FarwayDot/251115_ControlBoard/LIB_CAD/IRM-10 v3.step

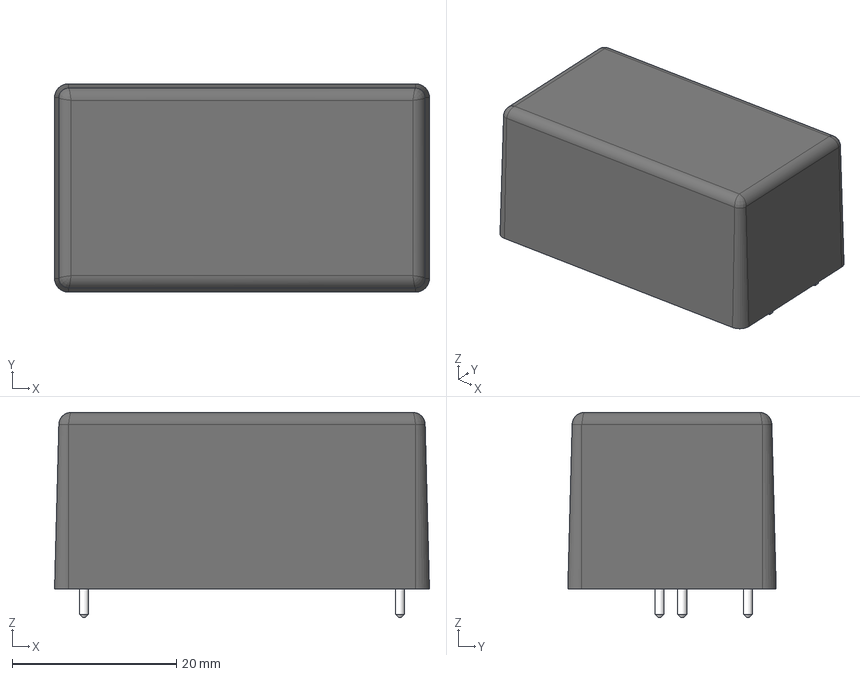
[picture p1: CAD file, 2025-11-26]
LIB_CAD/IRM-10 v3.step
45.7 x 25.4 x 25.0 mm
