FarwayDot/251115_ControlBoard/LIB_CAD/15EDGVC-3.81-06P-14-00AH.STEP

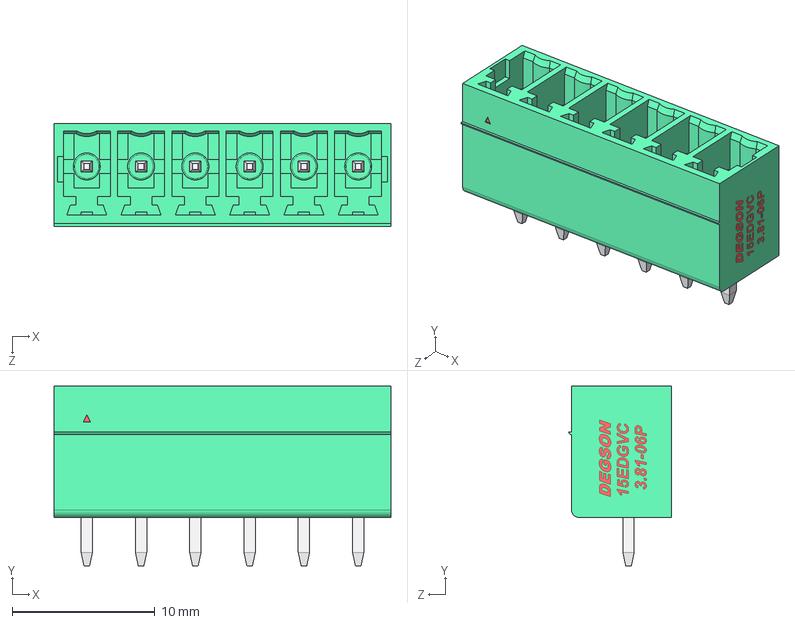
[picture p2: CAD file, 2025-11-24]
LIB_CAD/15EDGVC-3.81-06P-14-00AH.STEP
23.7 x 12.6 x 7.20 mm
