FarwayDot/251115_ControlBoard/LIB_CAD/15EDGK-3.81-06P-14-00AH.STEP

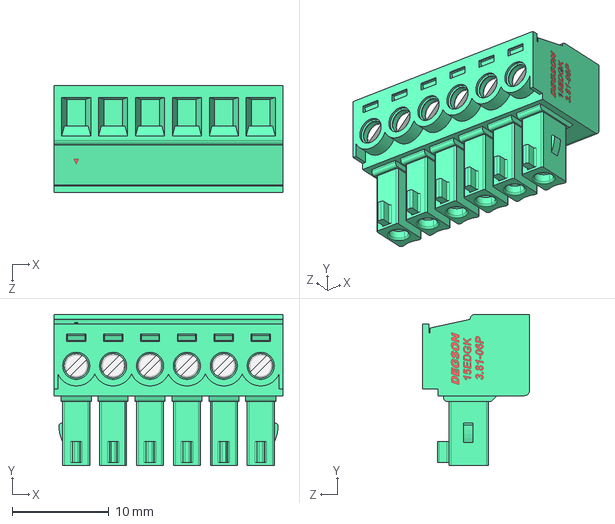
[picture p3: CAD file, 2025-11-24]
LIB_CAD/15EDGK-3.81-06P-14-00AH.STEP
23.7 x 15.6 x 11.1 mm
