FarwayDot/251115_ControlBoard/LIB_CAD/15EDGK-3.81-04P-14-00A&Z(H).stp

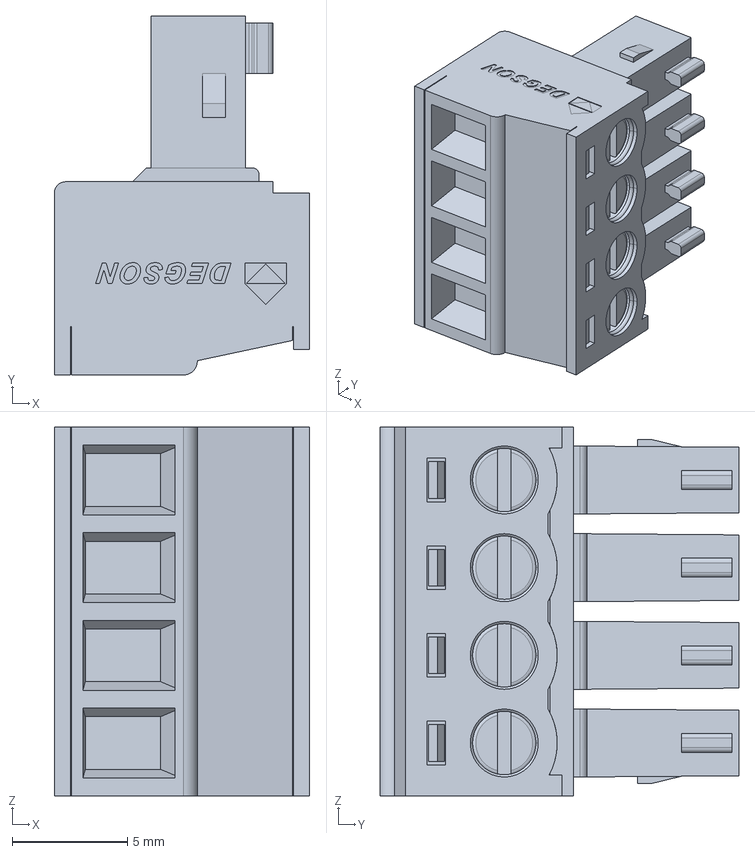
[picture p4: CAD file, 2025-11-21]
LIB_CAD/15EDGK-3.81-04P-14-00A&Z(H).stp
11.1 x 15.6 x 16.0 mm
