FarwayDot/251115_ControlBoard/LIB_CAD/15EDGVC-3.81-04P-14-00A&Z(H).stp

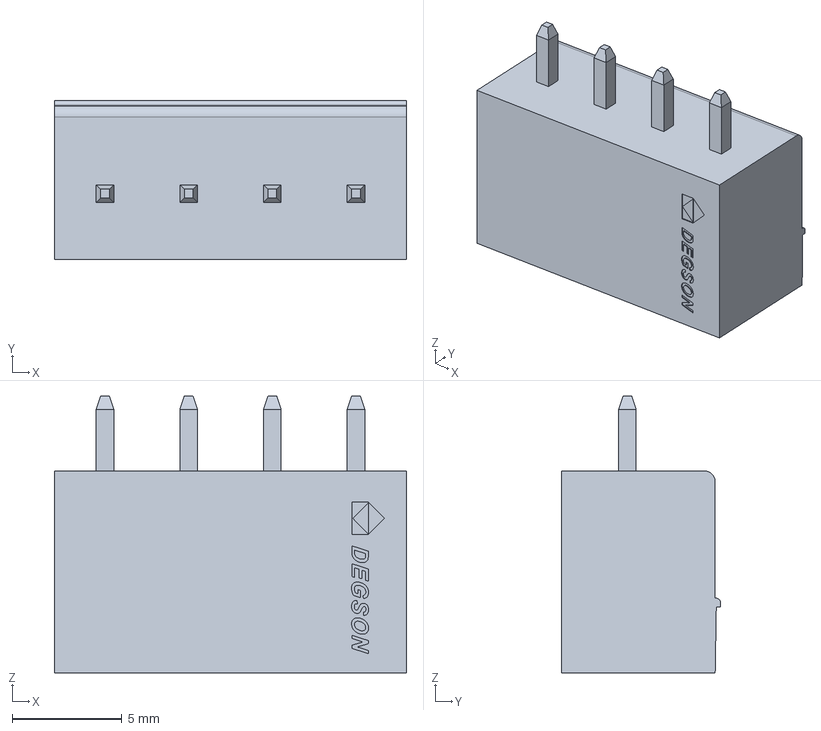
[picture p5: CAD file, 2025-11-21]
LIB_CAD/15EDGVC-3.81-04P-14-00A&Z(H).stp
16.0 x 7.24 x 12.6 mm
