FarwayDot/251115_ControlBoard/LIB_CAD/HF46F[1].stp

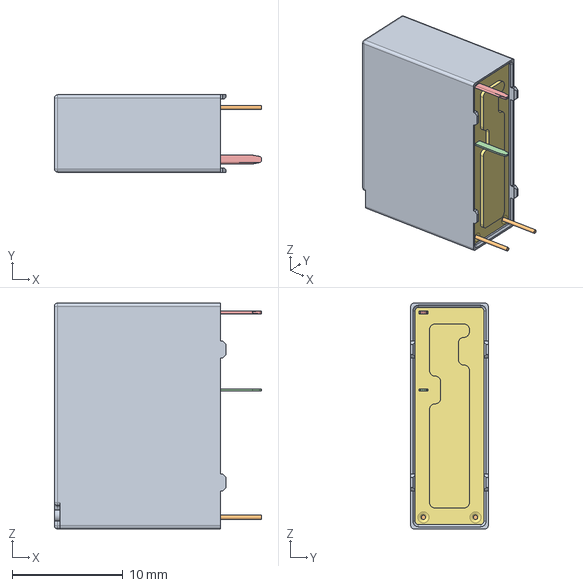
[picture p6: CAD file, 2025-11-19]
LIB_CAD/HF46F[1].stp
18.7 x 7.00 x 20.4 mm
