FarwayDot/251115_ControlBoard/LIB_CAD/15EDGRC-3.81-06P-1Y-00A&Z(H).stp

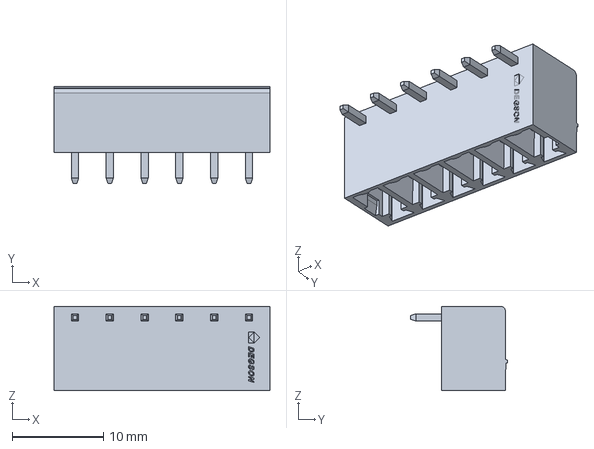
[picture p7: CAD file, 2025-11-19]
LIB_CAD/15EDGRC-3.81-06P-1Y-00A&Z(H).stp
23.6 x 10.6 x 9.20 mm
