FarwayDot/251115_ControlBoard/LIB_CAD/c-5-1393239-5-f-3d.stp

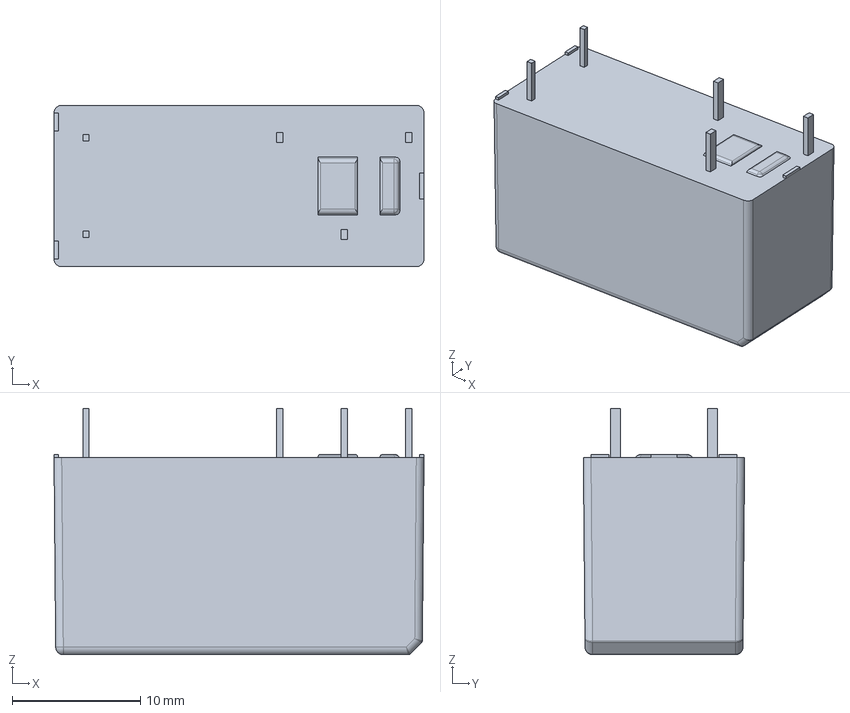
[picture p8: CAD file, 2025-11-15]
LIB_CAD/c-5-1393239-5-f-3d.stp
28.9 x 12.6 x 19.2 mm
