FarwayDot/251115_ControlBoard/Placa_Control_M2ES.kicad_pcb

## KiCad design Placa_Control_M2ES.kicad_pcb (2025-11-26)

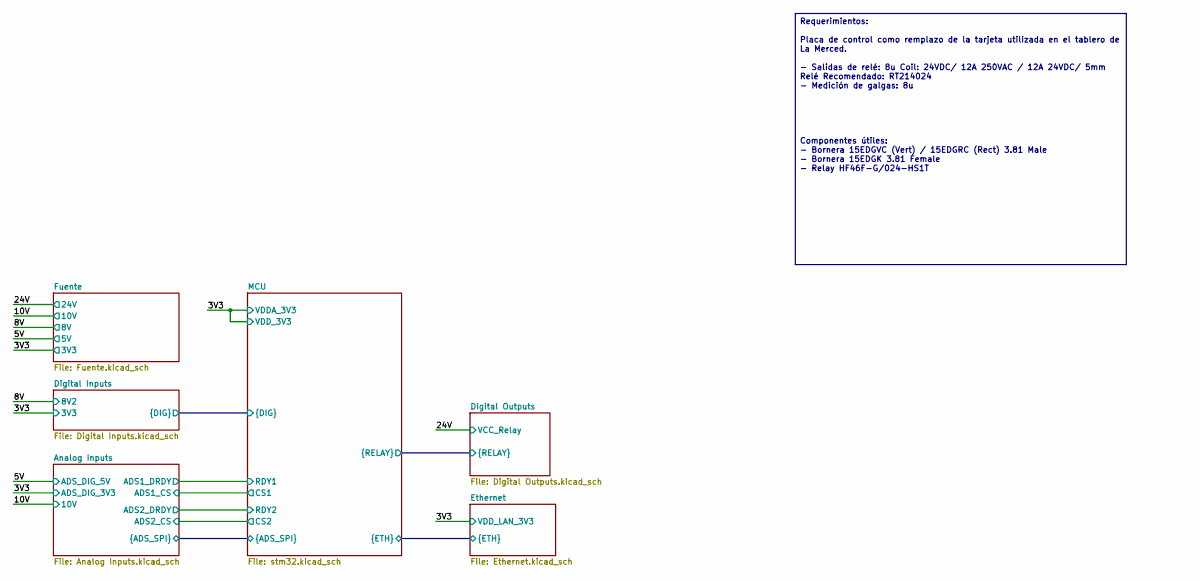
[picture p9: schematic Placa_Control_M2ES.kicad_sch]

Notes on the sheet:
Requerimientos: Placa de control como remplazo de la tarjeta utilizada en el tablero de La Merced. - Salidas de relé: 8u Coil: 24VDC/ 12A 250VAC / 12A 24VDC/ 5mm Relé Recomendado: RT214024 - Medición de galgas: 8u Componentes útiles: - Bornera 15EDGVC (Vert) / 15EDGRC (Rect) 3.81 Male - Bornera 15E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

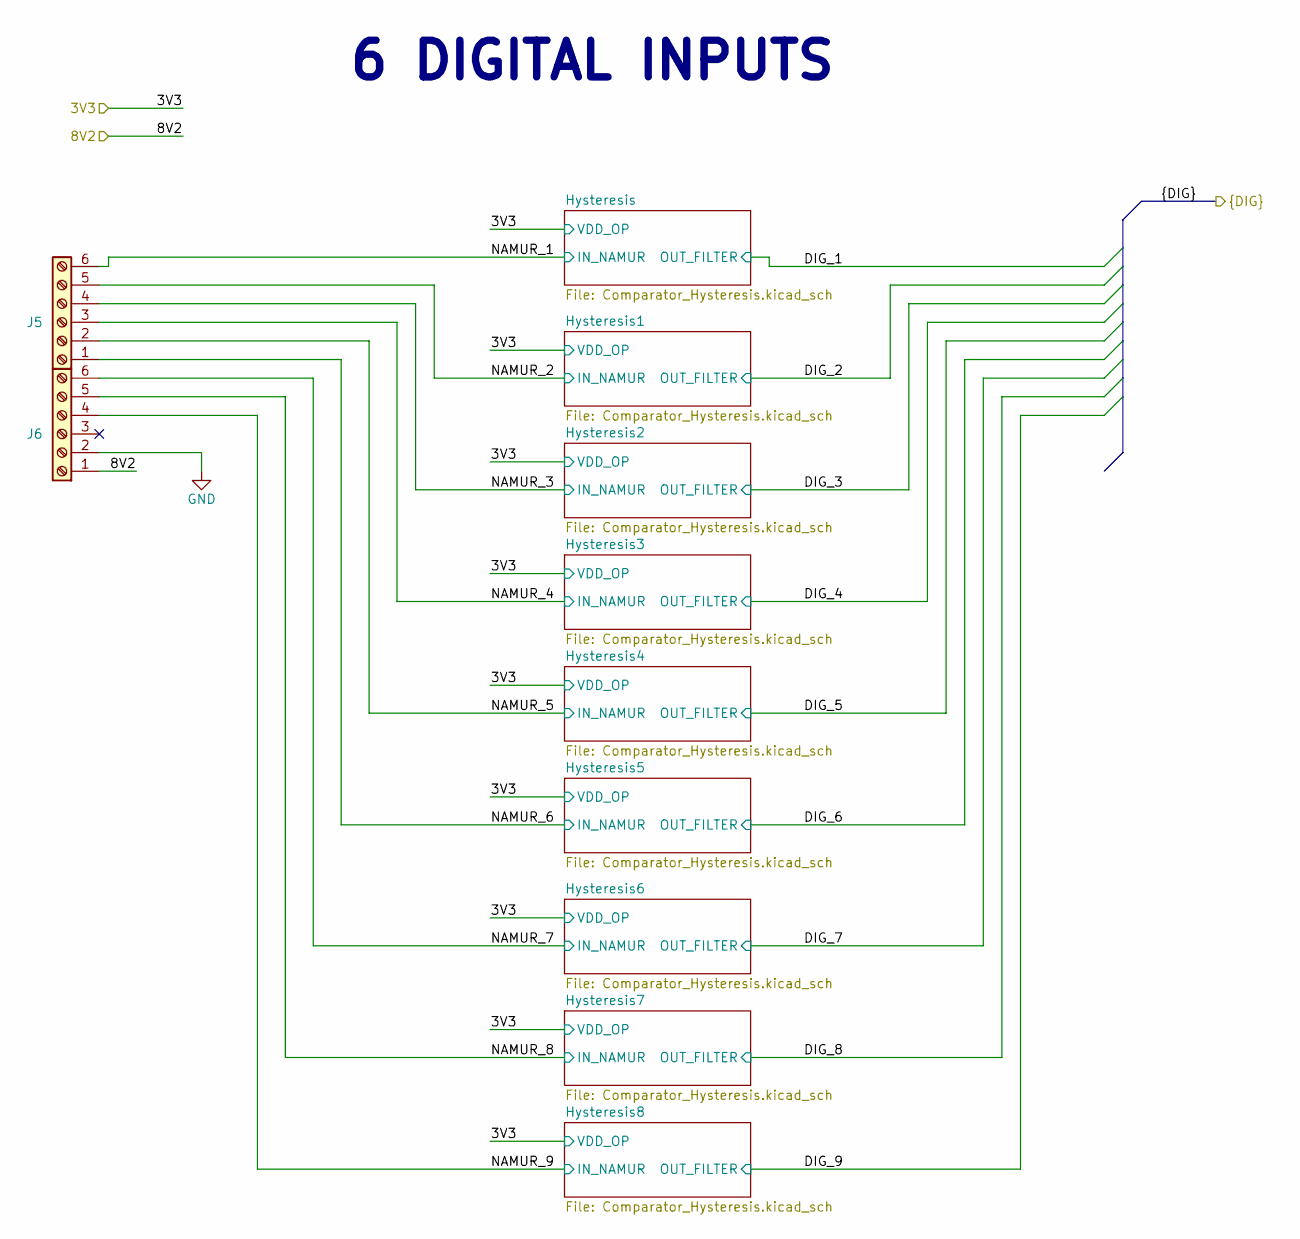
[picture p10: schematic Digital Inputs.kicad_sch]

Parts:
J5, J6: Screw_Terminal_01x06; 15EDGVC_6P_3.81mm_Male-Vert_Degson

Connections:
/8V: J6.1; also elsewhere on the board
/Digital Inputs/NAMUR_1: J5.6; also elsewhere on the board
/Digital Inputs/NAMUR_2: J5.5; also elsewhere on the board
/Digital Inputs/NAMUR_3: J5.4; also elsewhere on the board
/Digital Inputs/NAMUR_4: J5.3; also elsewhere on the board
/Digital Inputs/NAMUR_5: J5.2; also elsewhere on the board
/Digital Inputs/NAMUR_6: J5.1; also elsewhere on the board
/Digital Inputs/NAMUR_7: J6.6; also elsewhere on the board
/Digital Inputs/NAMUR_8: J6.5; also elsewhere on the board
/Digital Inputs/NAMUR_9: J6.4; also elsewhere on the board
GND: J6.2; also elsewhere on the board

Notes on the sheet:
6 DIGITAL INPUTS

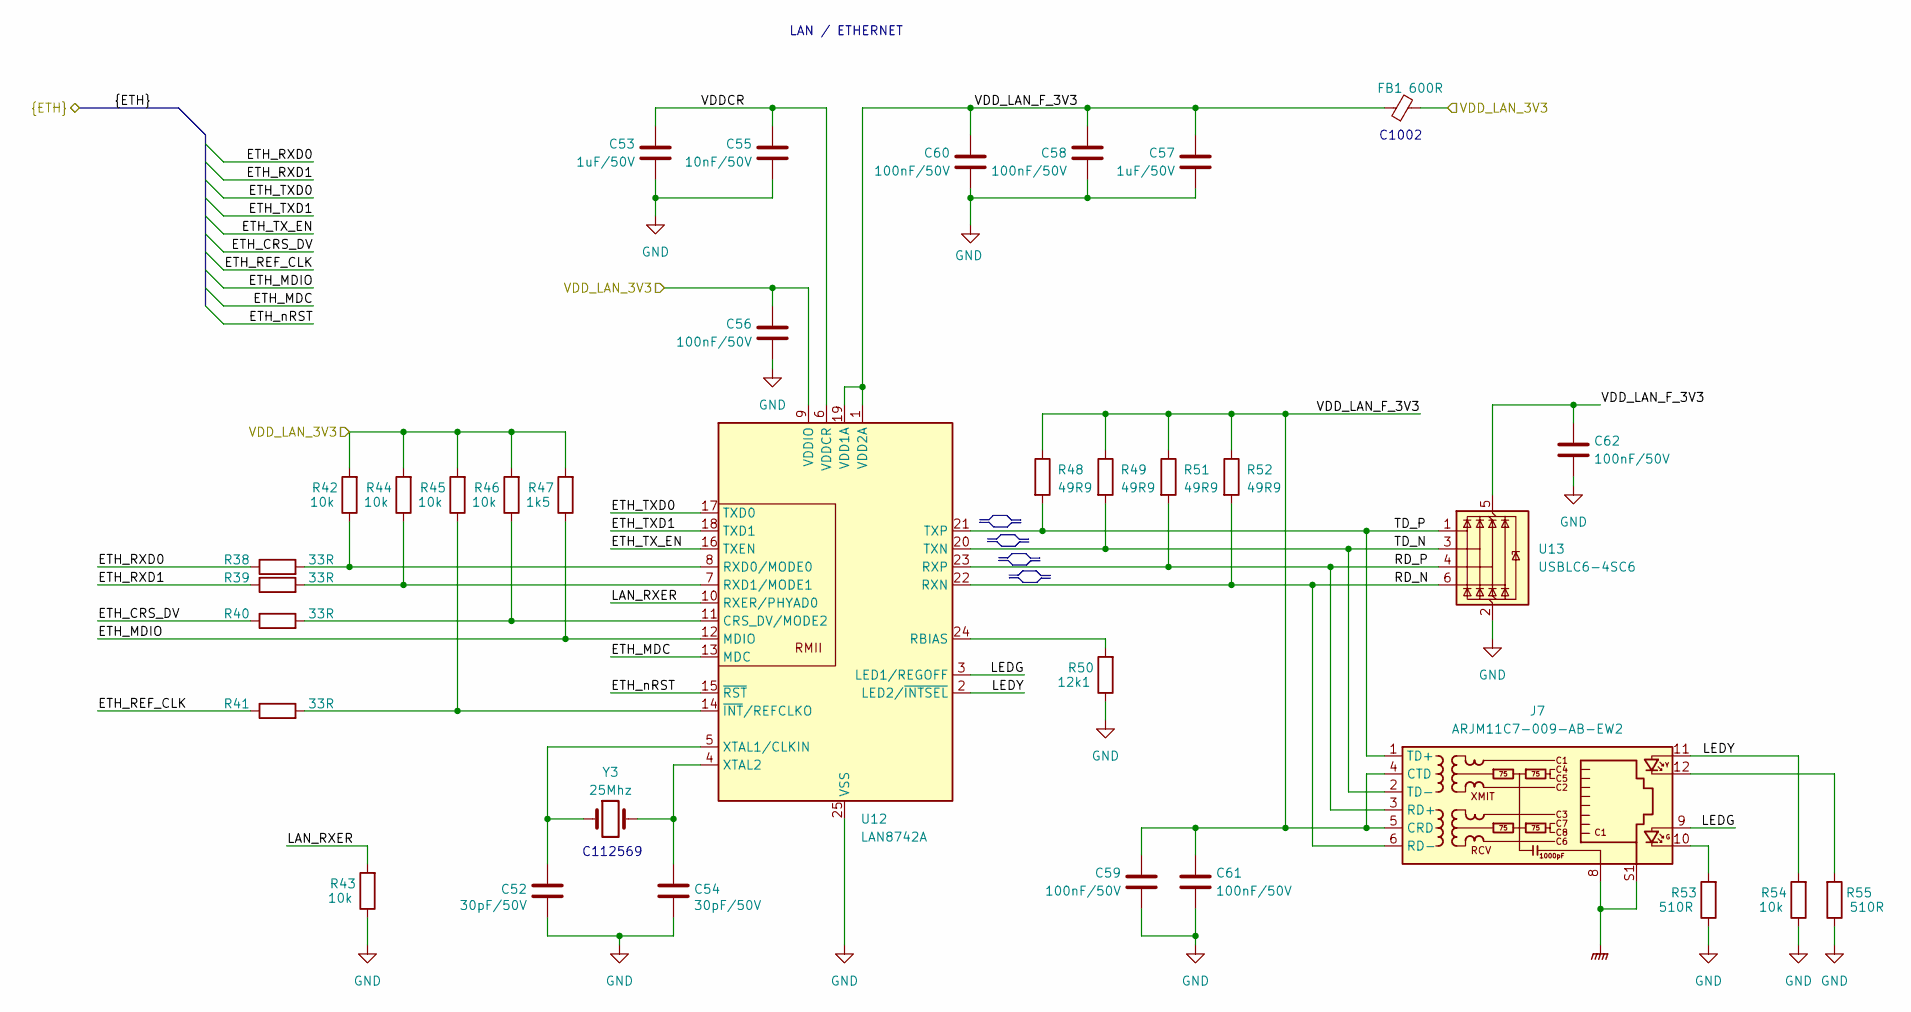
[picture p11: schematic Ethernet.kicad_sch]

Parts:
C52, C54: 30pF/50V; C_0603_1608Metric
C53: 1uF/50V; C_0805_2012Metric
C55: 10nF/50V; C_0603_1608Metric
C56, C58, C59, C60, C61, C62: 100nF/50V; C_0603_1608Metric
C57: 1uF/50V; C_0603_1608Metric
FB1: 600R; L_0805_2012Metric
J7: ARJM11C7-009-AB-EW2; ARJM11C7-009-AB-EW2_Abracon
R38, R39, R40, R41: 33R; R_0603_1608Metric
R42, R43, R44, R45, R46, R54: 10k; R_0603_1608Metric
R47: 1k5; R_0603_1608Metric
R48, R49, R51, R52: 49R9; R_0603_1608Metric
R50: 12k1; R_0603_1608Metric
R53, R55: 510R; R_0603_1608Metric
U12: LAN8742A; VQFN-24-1EP_4x4mm_P0.5mm_EP2.5x2.5mm_ThermalVias
U13: USBLC6-4SC6; SOT-23-6
Y3: 25Mhz; Crystal_SMD_5032-2Pin_5.0x3.2mm

Connections:
/Ethernet/ETH_CRS_DV: R40.1; also elsewhere on the board
/Ethernet/ETH_MDC: U12.13 (MDC); also elsewhere on the board
/Ethernet/ETH_MDIO: R47.1, U12.12 (MDIO); also elsewhere on the board
/Ethernet/ETH_REF_CLK: R41.1; also elsewhere on the board
/Ethernet/ETH_RXD0: R38.1; also elsewhere on the board
/Ethernet/ETH_RXD1: R39.1; also elsewhere on the board
/Ethernet/ETH_TXD0: U12.17 (TXD0); also elsewhere on the board
/Ethernet/ETH_TXD1: U12.18 (TXD1); also elsewhere on the board
/Ethernet/ETH_TX_EN: U12.16 (TXEN); also elsewhere on the board
/Ethernet/ETH_nRST: U12.15 (~RST); also elsewhere on the board
/Ethernet/LAN_RXER: R43.2, U12.10 (RXER/PHYAD0)
/Ethernet/LEDG: J7.9, U12.3 (LED1/REGOFF)
/Ethernet/LEDY: J7.11, R54.2, U12.2 (LED2/~INTSEL)
/Ethernet/RD_N: J7.6 (RD-), R52.2, U12.22 (RXN), U13.6 (I/O4)
/Ethernet/RD_P: J7.3 (RD+), R51.2, U12.23 (RXP), U13.4 (I/O3)
/Ethernet/TD_N: J7.2 (TD-), R49.2, U12.20 (TXN), U13.3 (I/O2)
/Ethernet/TD_P: J7.1 (TD+), R48.2, U12.21 (TXP), U13.1 (I/O1)
/Ethernet/VDDCR: C53.1, C55.1, U12.6 (VDDCR)
/Ethernet/VDD_LAN_F_3V3: C57.1, C58.1, C59.1, C60.1, C61.1, C62.1, FB1.1, J7.4 (CTD), J7.5 (CRD), R48.1, R49.1, R51.1, R52.1, U12.1 (VDD2A), U12.19 (VDD1A), U13.5 (VBUS)
GND: C52.2, C53.2, C54.2, C55.2, C56.2, C57.2, C58.2, C59.2, C60.2, C61.2, C62.2, R43.1, R50.1, R53.1, R54.1, R55.1, U12.25 (VSS), U13.2 (GND); also elsewhere on the board
GNDPWR: J7.8, J7.S1, J7.S2
unnamed: J7.10, R53.2
unnamed: J7.12, R55.2
unnamed: R40.2, R46.1, U12.11 (CRS_DV/MODE2)
unnamed: R50.2, U12.24 (RBIAS)
unnamed: R38.2, R42.1, U12.8 (RXD0/MODE0)
unnamed: R39.2, R44.1, U12.7 (RXD1/MODE1)
unnamed: C52.1, U12.5 (XTAL1/CLKIN), Y3.1
unnamed: C54.1, U12.4 (XTAL2), Y3.2
unnamed: R41.2, R45.1, U12.14 (~INT/REFCLKO)

Parts of its further copies:
R14, R17, R19, R21, R23: 10k; R_0603_1608Metric

Connections of its further copies:
/Analog Inputs/IN1_N: R23.2; also elsewhere on the board
/Analog Inputs/IN2_N: R17.1; also elsewhere on the board
/Analog Inputs/IN2_P: R14.1; also elsewhere on the board
/Analog Inputs/IN3_N: R19.2, R21.1; also elsewhere on the board
/Analog Inputs/SENS2_B: R17.2; also elsewhere on the board
/Analog Inputs/SENS3_B: R21.2; also elsewhere on the board
GND: R14.2, R19.1, R23.1; also elsewhere on the board

Notes on the sheet:
C112569
C1002
LAN / ETHERNET

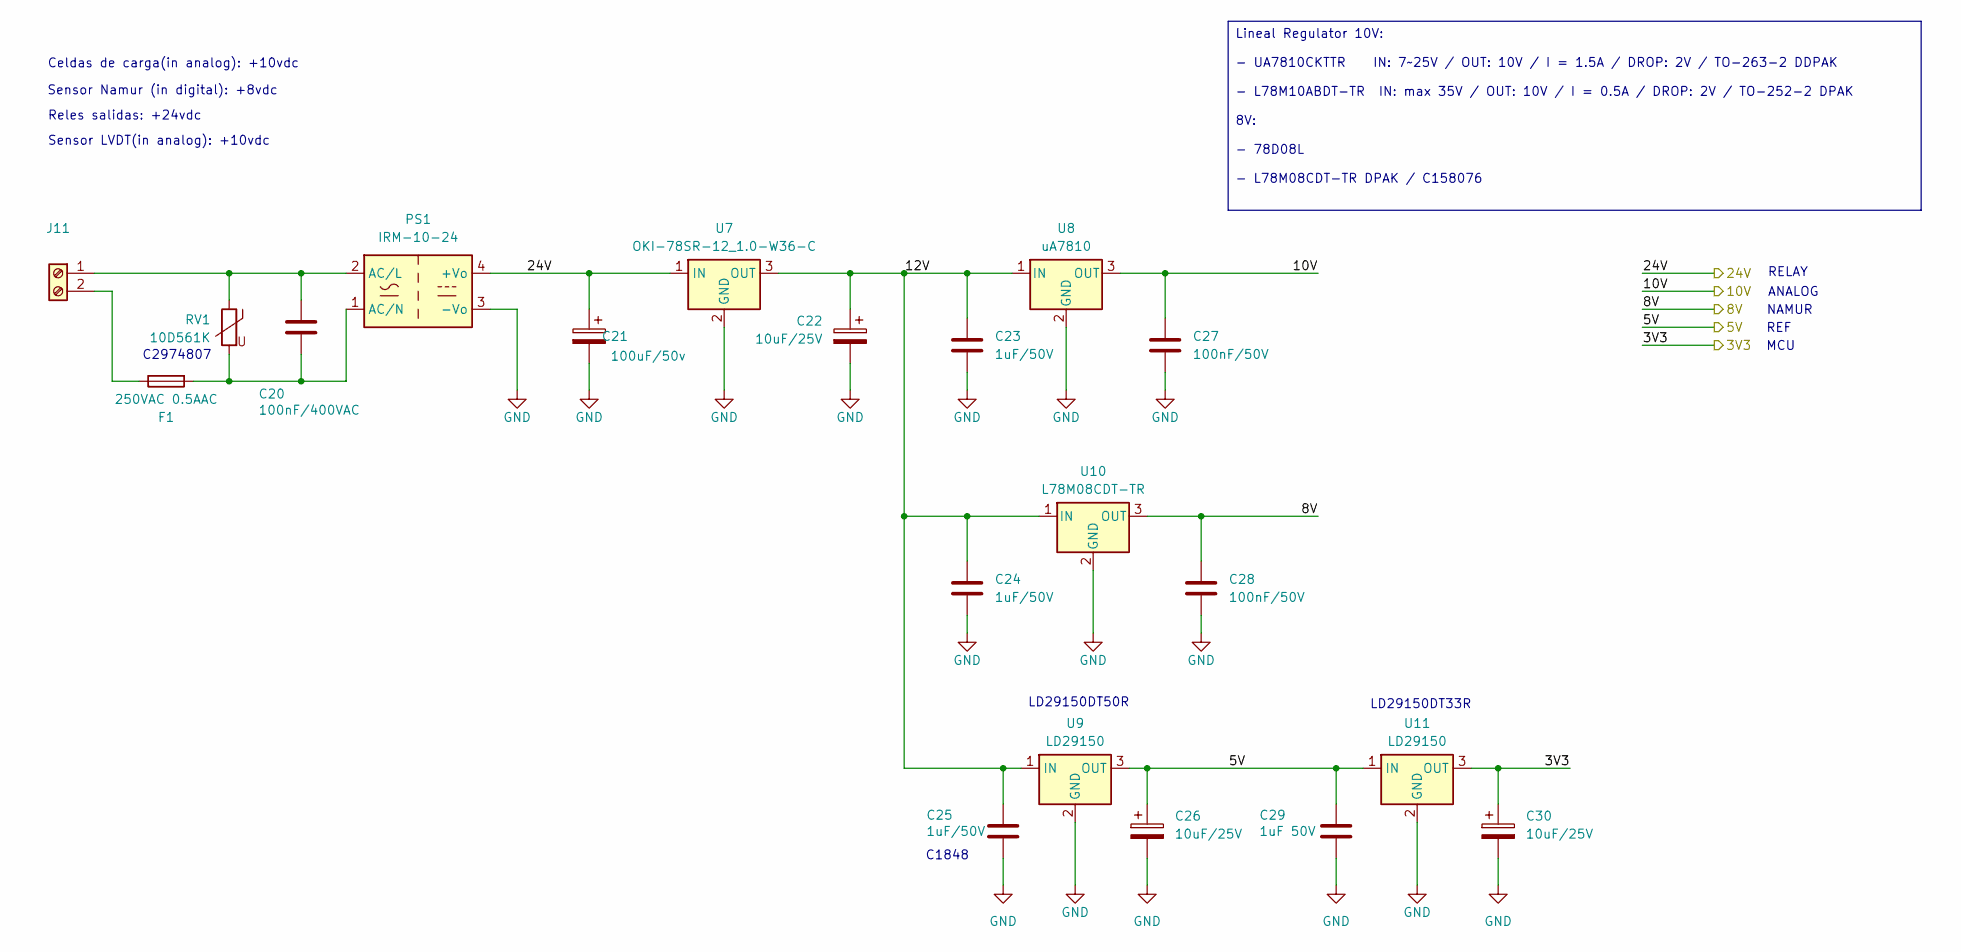
[picture p12: schematic Fuente.kicad_sch]

Parts:
C20: 100nF/400VAC; C_Disc_D10.5mm_W5.0mm_P7.50mm
C21: 100uF/50v; CP_Radial_D10.0mm_P5.00mm
C22, C26, C30: 10uF/25V; CP_Radial_D5.0mm_P2.50mm
C23, C24, C25: 1uF/50V; C_1206_3216Metric
C27, C28: 100nF/50V; C_0603_1608Metric
C29: 1uF 50V; C_1206_3216Metric
F1: 250VAC 0.5AAC; Fuseholder_TR5_Littelfuse_No560_No460
J11: Screw_Terminal_01x02; DG126_5.0_02P
PS1: IRM-10-24; Converter_ACDC_MeanWell_IRM-10-xx_THT
RV1: 10D561K; RV_Disc_D12mm_W3.9mm_P7.5mm
U7: OKI-78SR-12_1.0-W36-C; Converter_DCDC_Murata_OKI-78SR_Vertical
U8: uA7810; TO-263-3_TabPin2
U9, U11: LD29150; TO-252-2
U10: L78M08CDT-TR; TO-252-2

Connections:
/5V: C26.1, C29.1, U9.3 (OUT), U11.1 (IN); also elsewhere on the board
/8V: C28.1, U10.3 (OUT); also elsewhere on the board
/10V: C27.1, U8.3 (OUT); also elsewhere on the board
/24V: C21.1, PS1.4 (+Vo), U7.1 (IN); also elsewhere on the board
/Fuente/12V: C22.1, C23.1, C24.1, C25.1, U7.3 (OUT), U8.1 (IN), U9.1 (IN), U10.1 (IN)
GND: C21.2, C22.2, C23.2, C24.2, C25.2, C26.2, C27.2, C28.2, C29.2, C30.2, PS1.3 (-Vo), U7.2 (GND), U8.2 (GND), U9.2 (GND), U10.2 (GND), U11.2 (GND); also elsewhere on the board
unnamed: C20.1, J11.1, PS1.2 (AC/L), RV1.1
unnamed: F1.1, J11.2
unnamed: C20.2, F1.2, PS1.1 (AC/N), RV1.2

Notes on the sheet:
C1848
RELAY
Sensor Namur (in digital): +8vdc
Reles salidas: +24vdc
LD29150DT33R
C2974807
LD29150DT50R
REF
ANALOG
Celdas de carga(in analog): +10vdc
NAMUR
MCU
Sensor LVDT(in analog): +10vdc
Lineal Regulator 10V: - UA7810CKTTR IN: 7~25V / OUT: 10V / I = 1.5A / DROP: 2V / TO-263-2 DDPAK - L78M10ABDT-TR IN: max 35V / OUT: 10V / I = 0.5A / DROP: 2V / TO-252-2 DPAK 8V: - 78D08L - L78M08CDT-TR DPAK / C158076

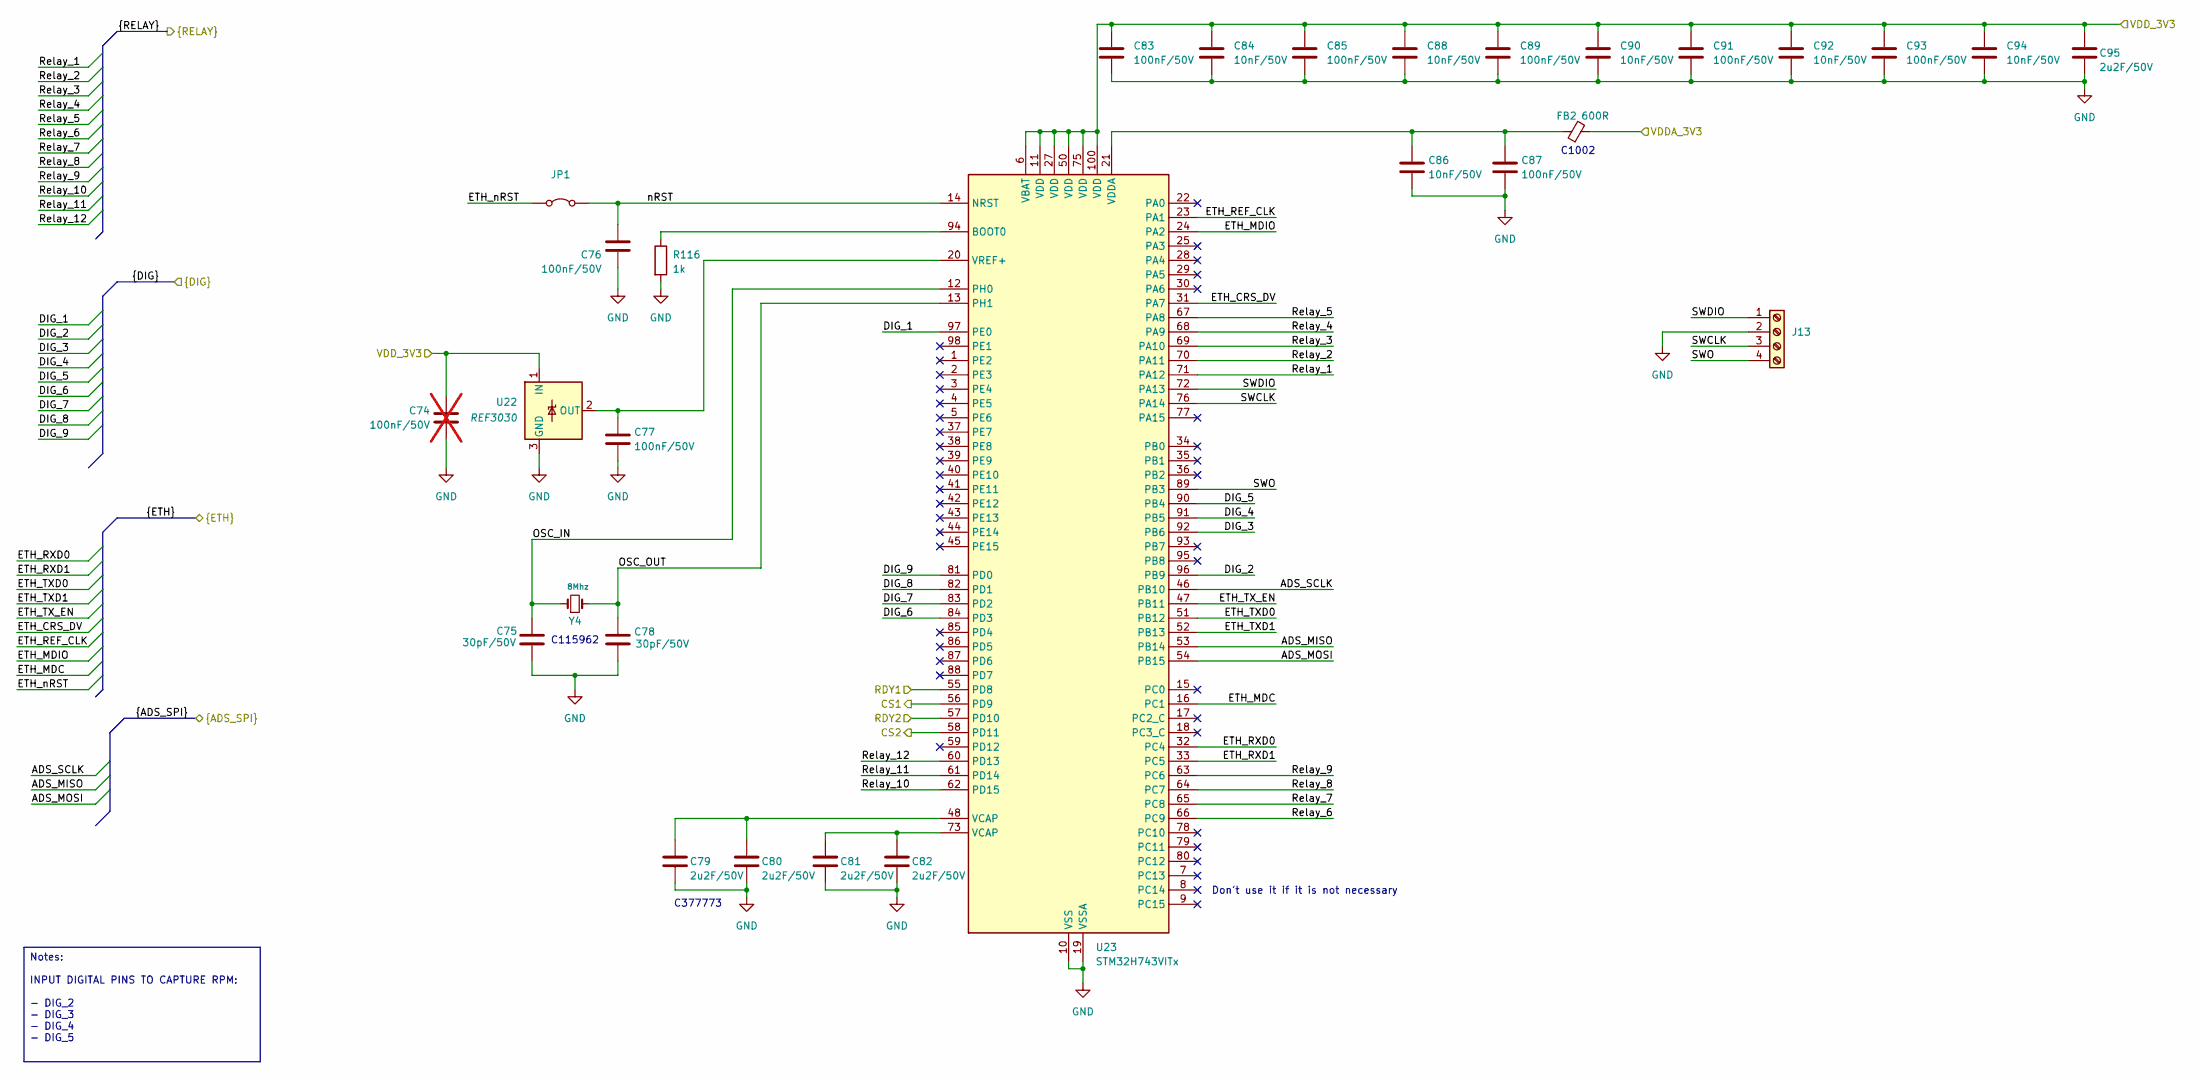
[picture p13: schematic stm32.kicad_sch]

Parts:
C74: 100nF/50V; C_0603_1608Metric; not fitted
C75, C78: 30pF/50V; C_0603_1608Metric
C76, C77, C83, C85, C87, C89, C91, C93: 100nF/50V; C_0603_1608Metric
C79, C80, C81, C82, C95: 2u2F/50V; C_0805_2012Metric
C84, C86, C88, C90, C92, C94: 10nF/50V; C_0603_1608Metric
FB2: 600R; L_0805_2012Metric
J13: Screw_Terminal_01x04; PinHeader_1x04_P2.54mm_Vertical
JP1: Jumper_2_Bridged; SolderJumper-2_P1.3mm_Open_Pad1.0x1.5mm
R116: 1k; R_0603_1608Metric
U22: REF3030; SOT-23
U23: STM32H743VITx; LQFP-100_14x14mm_P0.5mm
Y4: 8Mhz; Crystal_SMD_5032-2Pin_5.0x3.2mm

Connections:
/Analog Inputs/ADS1_CS: U23.56 (PD9); also elsewhere on the board
/Analog Inputs/ADS1_DRDY: U23.55 (PD8); also elsewhere on the board
/Analog Inputs/ADS2_CS: U23.58 (PD11); also elsewhere on the board
/Analog Inputs/ADS2_DRDY: U23.57 (PD10); also elsewhere on the board
/Analog Inputs/ADS_MISO: U23.53 (PB14); also elsewhere on the board
/Analog Inputs/ADS_MOSI: U23.54 (PB15); also elsewhere on the board
/Analog Inputs/ADS_SCLK: U23.46 (PB10); also elsewhere on the board
/Digital Inputs/DIG_1: U23.97 (PE0); also elsewhere on the board
/Digital Inputs/DIG_2: U23.96 (PB9); also elsewhere on the board
/Digital Inputs/DIG_3: U23.92 (PB6); also elsewhere on the board
/Digital Inputs/DIG_4: U23.91 (PB5); also elsewhere on the board
/Digital Inputs/DIG_5: U23.90 (PB4); also elsewhere on the board
/Digital Inputs/DIG_6: U23.84 (PD3); also elsewhere on the board
/Digital Inputs/DIG_7: U23.83 (PD2); also elsewhere on the board
/Digital Inputs/DIG_8: U23.82 (PD1); also elsewhere on the board
/Digital Inputs/DIG_9: U23.81 (PD0); also elsewhere on the board
/Digital Outputs/Relay_1: U23.71 (PA12); also elsewhere on the board
/Digital Outputs/Relay_2: U23.70 (PA11); also elsewhere on the board
/Digital Outputs/Relay_3: U23.69 (PA10); also elsewhere on the board
/Digital Outputs/Relay_4: U23.68 (PA9); also elsewhere on the board
/Digital Outputs/Relay_5: U23.67 (PA8); also elsewhere on the board
/Digital Outputs/Relay_6: U23.66 (PC9); also elsewhere on the board
/Digital Outputs/Relay_7: U23.65 (PC8); also elsewhere on the board
/Digital Outputs/Relay_8: U23.64 (PC7); also elsewhere on the board
/Digital Outputs/Relay_9: U23.63 (PC6); also elsewhere on the board
/Digital Outputs/Relay_10: U23.62 (PD15); also elsewhere on the board
/Digital Outputs/Relay_11: U23.61 (PD14); also elsewhere on the board
/Digital Outputs/Relay_12: U23.60 (PD13); also elsewhere on the board
/Ethernet/ETH_CRS_DV: U23.31 (PA7); also elsewhere on the board
/Ethernet/ETH_MDC: U23.16 (PC1); also elsewhere on the board
/Ethernet/ETH_MDIO: U23.24 (PA2); also elsewhere on the board
/Ethernet/ETH_REF_CLK: U23.23 (PA1); also elsewhere on the board
/Ethernet/ETH_RXD0: U23.32 (PC4); also elsewhere on the board
/Ethernet/ETH_RXD1: U23.33 (PC5); also elsewhere on the board
/Ethernet/ETH_TXD0: U23.51 (PB12); also elsewhere on the board
/Ethernet/ETH_TXD1: U23.52 (PB13); also elsewhere on the board
/Ethernet/ETH_TX_EN: U23.47 (PB11); also elsewhere on the board
/Ethernet/ETH_nRST: JP1.1 (A); also elsewhere on the board
/MCU/OSC_IN: C75.1, U23.12 (PH0), Y4.1
/MCU/OSC_OUT: C78.1, U23.13 (PH1), Y4.2
/MCU/SWCLK: J13.3, U23.76 (PA14)
/MCU/SWDIO: J13.1, U23.72 (PA13)
/MCU/SWO: J13.4, U23.89 (PB3)
/MCU/nRST: C76.1, JP1.2 (B), U23.14 (NRST)
GND: C75.2, C76.2, C77.2, C78.2, C79.2, C80.2, C81.2, C82.2, C83.2, C84.2, C85.2, C86.2, C87.2, C88.2, C89.2, C90.2, C91.2, C92.2, C93.2, C94.2, C95.2, J13.2, R116.2, U22.3 (GND), U23.10 (VSS), U23.19 (VSSA), U23.26 (VSS), U23.49 (VSS), U23.74 (VSS), U23.99 (VSS); also elsewhere on the board
unnamed: C79.1, C80.1, U23.48 (VCAP)
unnamed: C81.1, C82.1, U23.73 (VCAP)
unnamed: C77.1, U22.2 (OUT), U23.20 (VREF+)
unnamed: R116.1, U23.94 (BOOT0)
unnamed: C86.1, C87.1, FB2.1, U23.21 (VDDA)

Notes on the sheet:
C115962
C377773
C1002
Don't use it if it is not necessary
Notes: INPUT DIGITAL PINS TO CAPTURE RPM: - DIG_2 - DIG_3 - DIG_4 - DIG_5

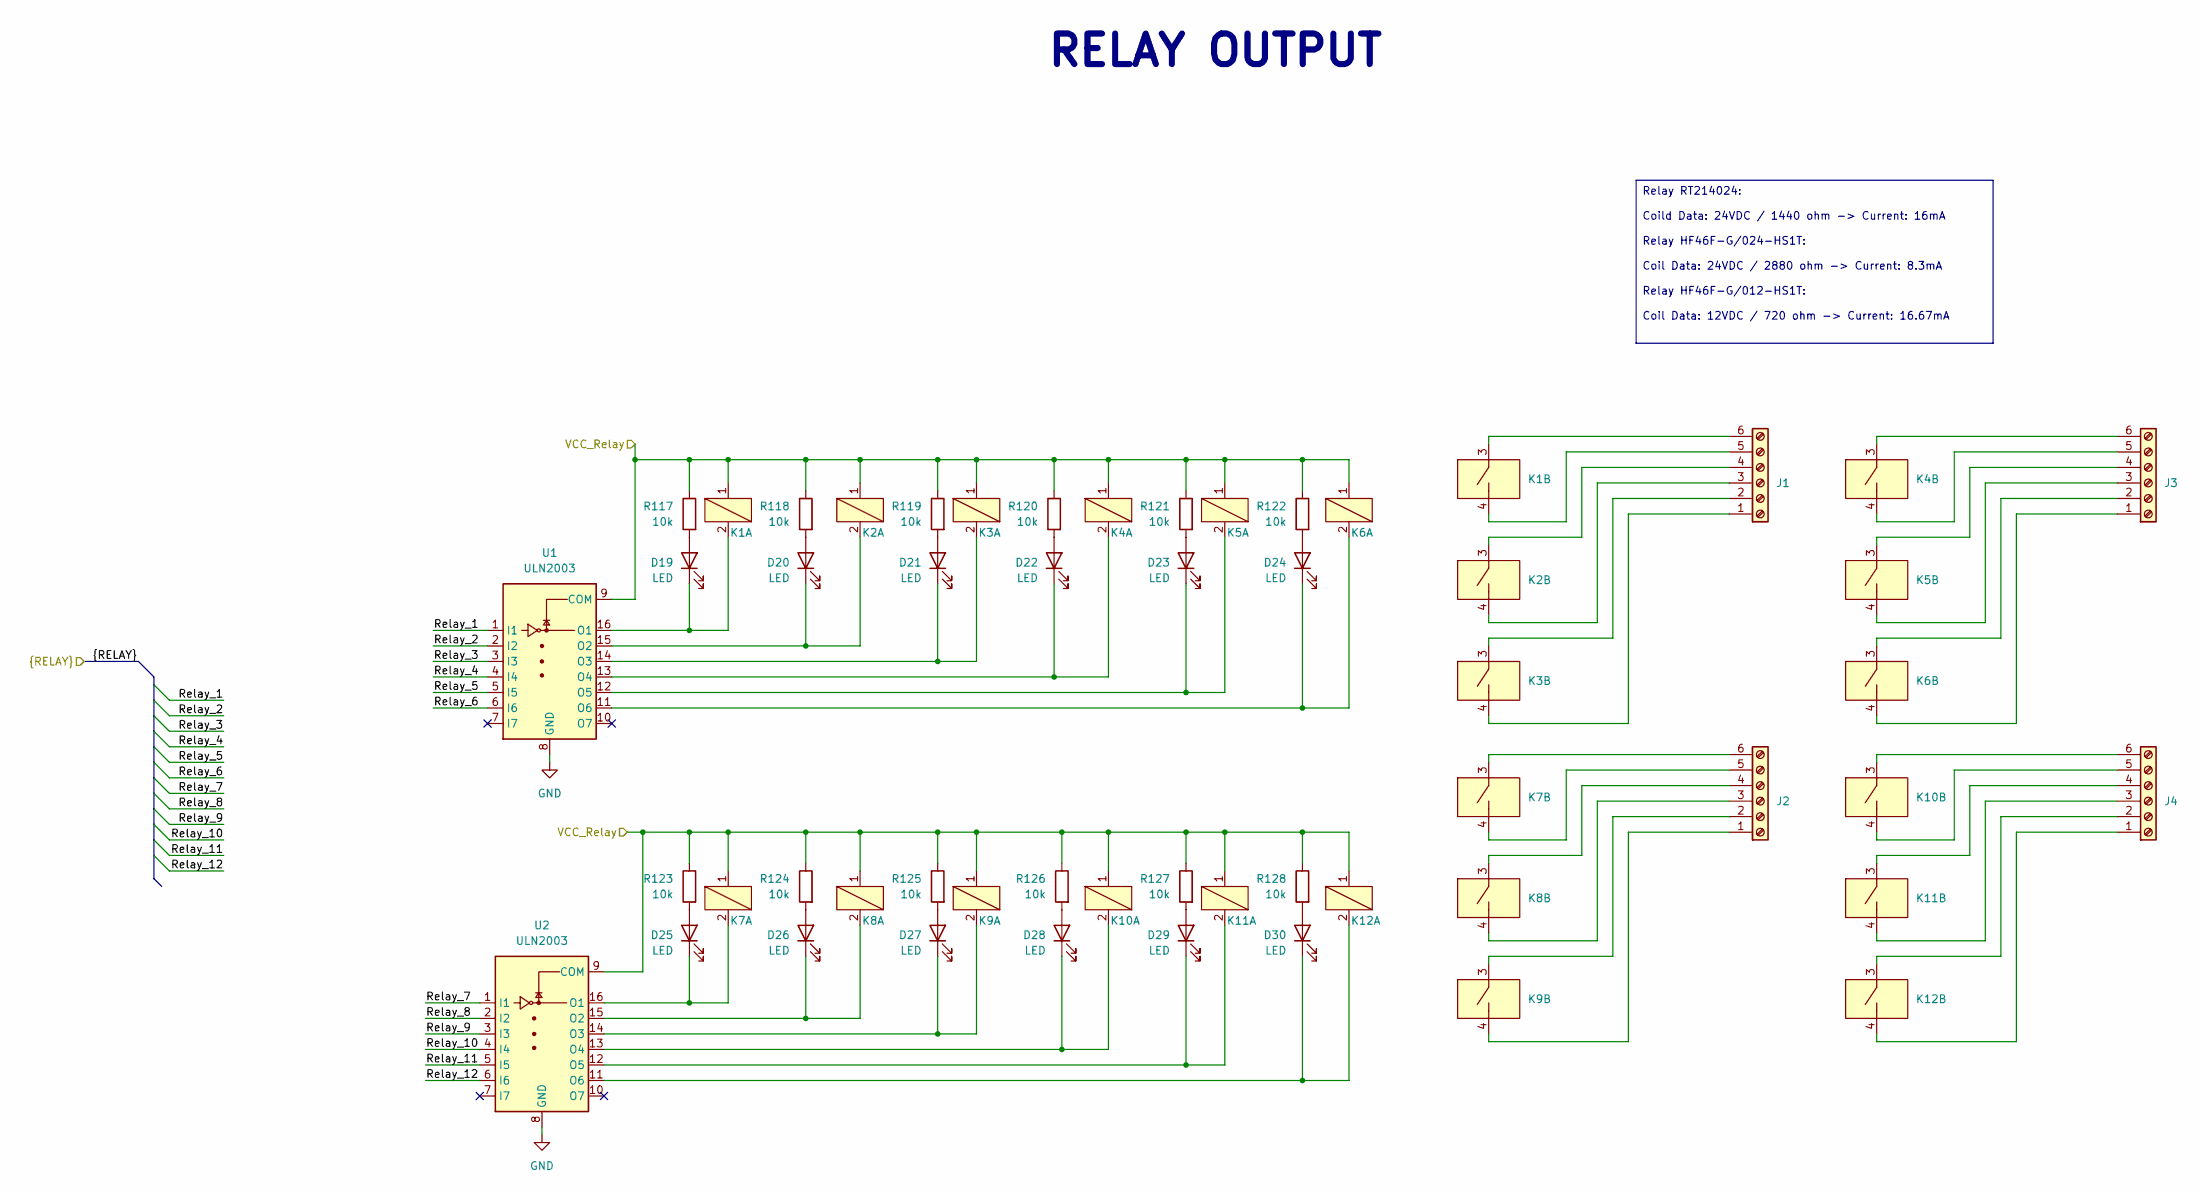
[picture p14: schematic Digital Outputs.kicad_sch]

Parts:
D19, D20, D21, D22, D23, D24, D25, D26, D27, D28, D29, D30: LED; LED_0603_1608Metric
J1, J2, J3, J4: Screw_Terminal_01x06; 15EDGVC_6P_3.81mm_Male-Vert_Degson
K1, K2, K3, K4, K5, K6, K7, K8, K9, K10, K11, K12: HF46F-G; Relay_HF46F-G_Hongfa
R117, R118, R119, R120, R121, R122, R123, R124, R125, R126, R127, R128: 10k; R_0603_1608Metric
U1, U2: ULN2003; SOIC-16_3.9x9.9mm_P1.27mm

Connections:
/24V: K1.1, K2.1, K3.1, K4.1, K5.1, K6.1, K7.1, K8.1, K9.1, K10.1, K11.1, K12.1, R117.1, R118.1, R119.1, R120.1, R121.1, R122.1, R123.1, R124.1, R125.1, R126.1, R127.1, R128.1, U1.9 (COM), U2.9 (COM); also elsewhere on the board
/Digital Outputs/Relay_1: U1.1 (I1); also elsewhere on the board
/Digital Outputs/Relay_2: U1.2 (I2); also elsewhere on the board
/Digital Outputs/Relay_3: U1.3 (I3); also elsewhere on the board
/Digital Outputs/Relay_4: U1.4 (I4); also elsewhere on the board
/Digital Outputs/Relay_5: U1.5 (I5); also elsewhere on the board
/Digital Outputs/Relay_6: U1.6 (I6); also elsewhere on the board
/Digital Outputs/Relay_7: U2.1 (I1); also elsewhere on the board
/Digital Outputs/Relay_8: U2.2 (I2); also elsewhere on the board
/Digital Outputs/Relay_9: U2.3 (I3); also elsewhere on the board
/Digital Outputs/Relay_10: U2.4 (I4); also elsewhere on the board
/Digital Outputs/Relay_11: U2.5 (I5); also elsewhere on the board
/Digital Outputs/Relay_12: U2.6 (I6); also elsewhere on the board
GND: U1.8 (GND), U2.8 (GND); also elsewhere on the board
unnamed: D19.2 (A), R117.2
unnamed: D19.1 (K), K1.2, U1.16 (O1)
unnamed: D20.2 (A), R118.2
unnamed: D20.1 (K), K2.2, U1.15 (O2)
unnamed: D21.2 (A), R119.2
unnamed: D21.1 (K), K3.2, U1.14 (O3)
unnamed: D22.2 (A), R120.2
unnamed: D22.1 (K), K4.2, U1.13 (O4)
unnamed: D23.2 (A), R121.2
unnamed: D23.1 (K), K5.2, U1.12 (O5)
unnamed: D24.2 (A), R122.2
unnamed: D24.1 (K), K6.2, U1.11 (O6)
unnamed: D25.2 (A), R123.2
unnamed: D25.1 (K), K7.2, U2.16 (O1)
unnamed: D26.2 (A), R124.2
unnamed: D26.1 (K), K8.2, U2.15 (O2)
unnamed: D27.2 (A), R125.2
unnamed: D27.1 (K), K9.2, U2.14 (O3)
unnamed: D28.2 (A), R126.2
unnamed: D28.1 (K), K10.2, U2.13 (O4)
unnamed: D29.2 (A), R127.2
unnamed: D29.1 (K), K11.2, U2.12 (O5)
unnamed: D30.2 (A), R128.2
unnamed: D30.1 (K), K12.2, U2.11 (O6)
unnamed: J1.1, K3.4 (NO)
unnamed: J1.2, K3.3 (COM)
unnamed: J1.3, K2.4 (NO)
unnamed: J1.4, K2.3 (COM)
unnamed: J1.5, K1.4 (NO)
unnamed: J1.6, K1.3 (COM)
unnamed: J2.1, K9.4 (NO)
unnamed: J2.2, K9.3 (COM)
unnamed: J2.3, K8.4 (NO)
unnamed: J2.4, K8.3 (COM)
unnamed: J2.5, K7.4 (NO)
unnamed: J2.6, K7.3 (COM)
unnamed: J3.1, K6.4 (NO)
unnamed: J3.2, K6.3 (COM)
unnamed: J3.3, K5.4 (NO)
unnamed: J3.4, K5.3 (COM)
unnamed: J3.5, K4.4 (NO)
unnamed: J3.6, K4.3 (COM)
unnamed: J4.1, K12.4 (NO)
unnamed: J4.2, K12.3 (COM)
unnamed: J4.3, K11.4 (NO)
unnamed: J4.4, K11.3 (COM)
unnamed: J4.5, K10.4 (NO)
unnamed: J4.6, K10.3 (COM)

Notes on the sheet:
RELAY OUTPUT
Relay RT214024: Coild Data: 24VDC / 1440 ohm -> Current: 16mA Relay HF46F-G/024-HS1T: Coil Data: 24VDC / 2880 ohm -> Current: 8.3mA Relay HF46F-G/012-HS1T: Coil Data: 12VDC / 720 ohm -> Current: 16.67mA
