FarwayDot/251115_ControlBoard/Placa_Control_M2ES.kicad_pcb

## KiCad design Placa_Control_M2ES.kicad_pcb (continued)

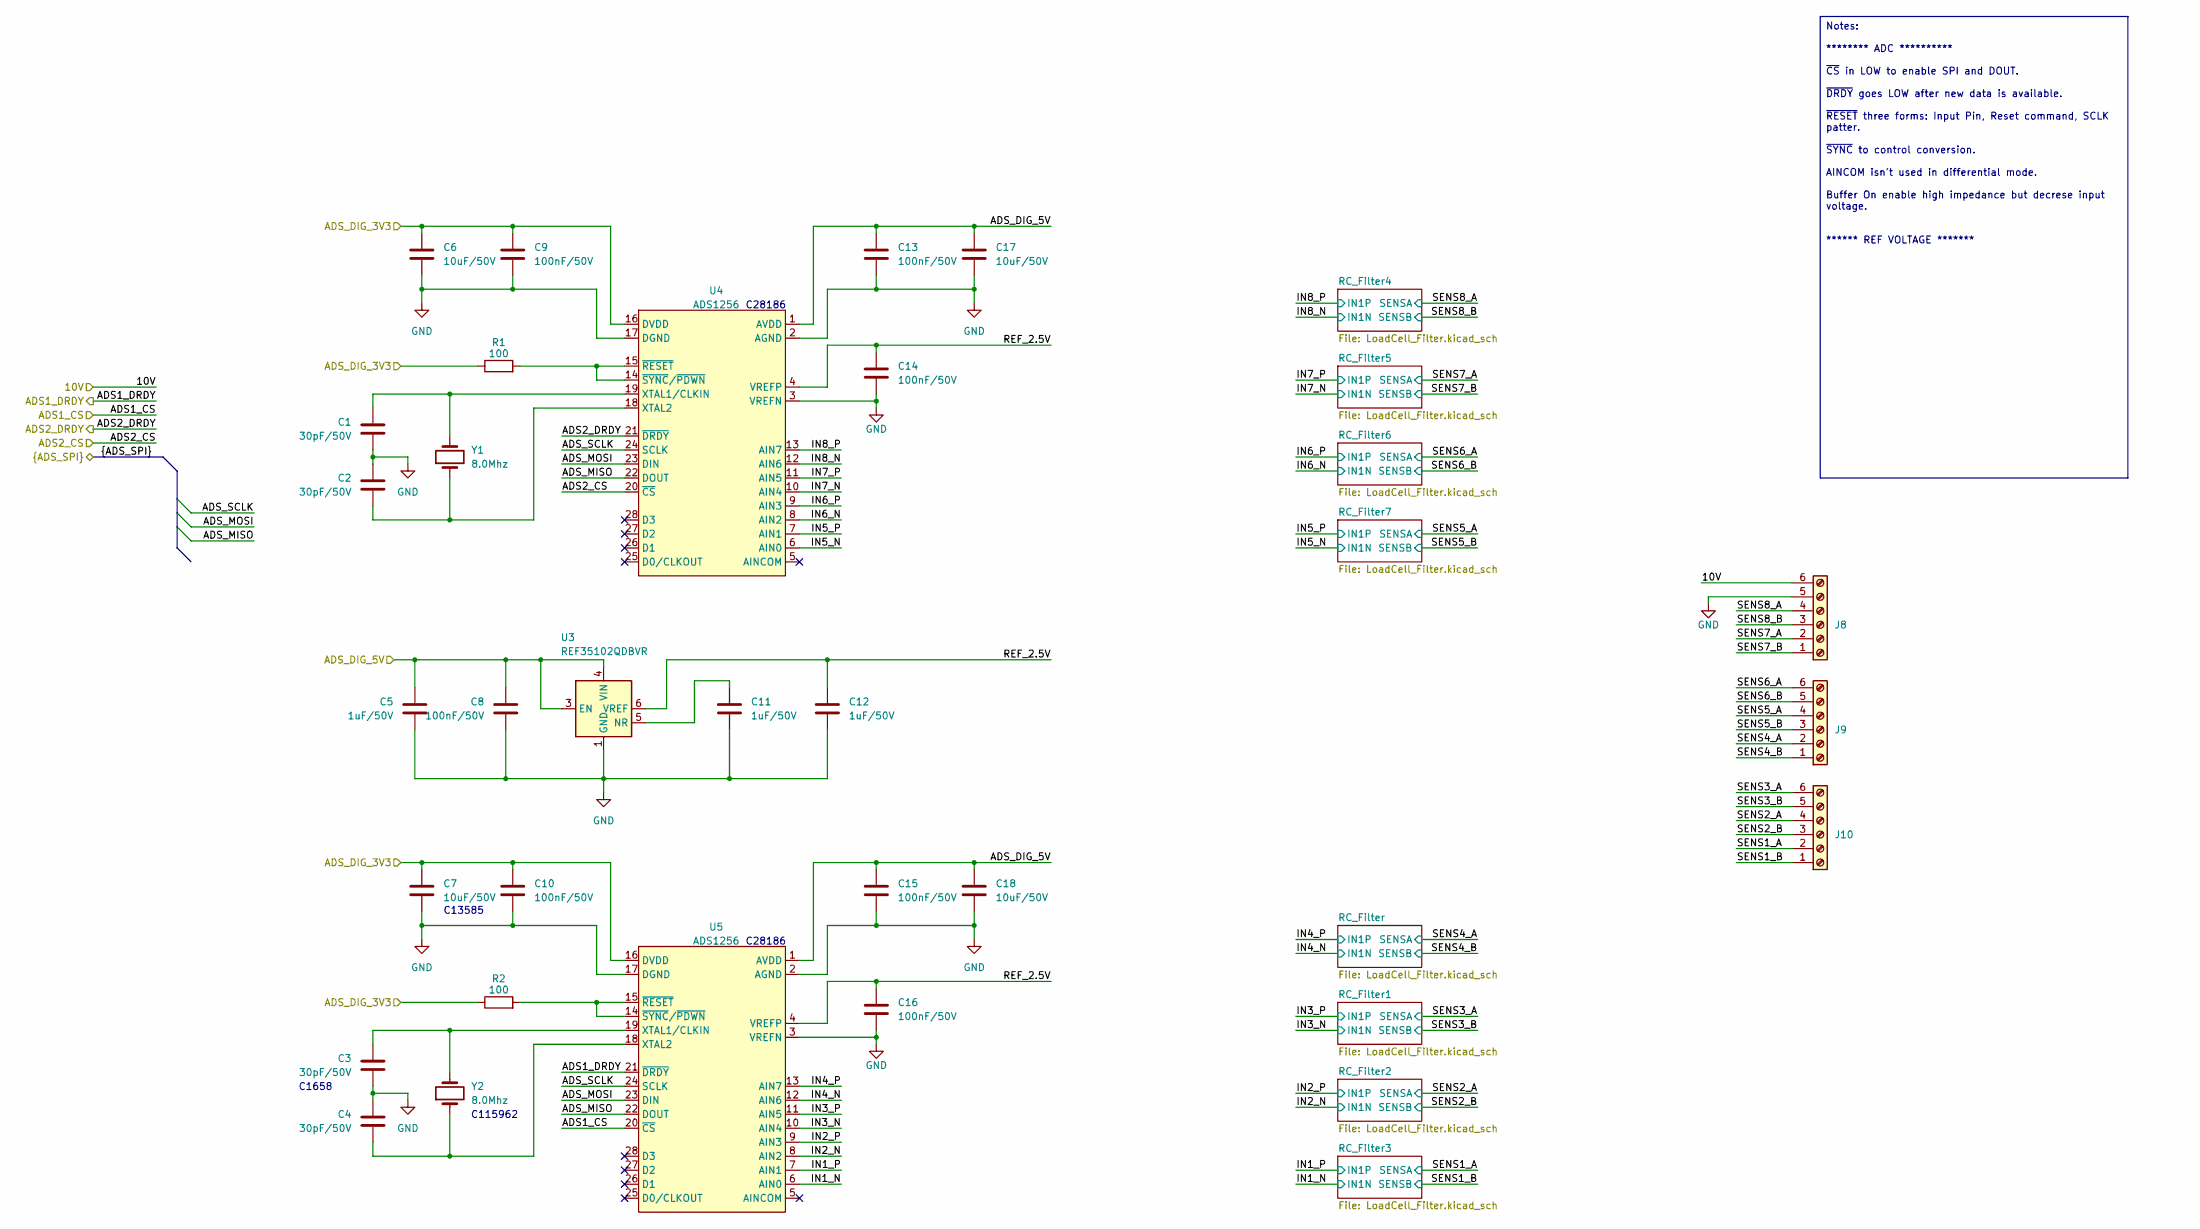
[picture p15: schematic Analog Inputs.kicad_sch]

Parts:
C1, C2, C3, C4: 30pF/50V; C_0603_1608Metric
C5, C11, C12: 1uF/50V; R_0805_2012Metric_Pad1.20x1.40mm_HandSolder
C6, C7, C17, C18: 10uF/50V; R_1206_3216Metric_Pad1.30x1.75mm_HandSolder
C8, C9, C10, C13, C14, C15, C16: 100nF/50V; R_0805_2012Metric_Pad1.20x1.40mm_HandSolder
J8, J9, J10: Screw_Terminal_01x06; 15EDGVC_6P_3.81mm_Male-Vert_Degson
R1, R2: 100; R_0603_1608Metric
U3: REF35102QDBVR; SOT-23-6
U4, U5: ADS1256; SSOP-28_5.3x10.2mm_P0.65mm
Y1, Y2: 8.0Mhz; Crystal_SMD_5032-2Pin_5.0x3.2mm

Connections:
/5V: C5.1, C8.1, C13.1, C15.1, C17.1, C18.1, U3.3 (EN), U3.4 (VIN), U4.1 (AVDD), U5.1 (AVDD); also elsewhere on the board
/10V: J8.6; also elsewhere on the board
/Analog Inputs/ADS1_CS: U5.20 (~CS); also elsewhere on the board
/Analog Inputs/ADS1_DRDY: U5.21 (~DRDY); also elsewhere on the board
/Analog Inputs/ADS2_CS: U4.20 (~CS); also elsewhere on the board
/Analog Inputs/ADS2_DRDY: U4.21 (~DRDY); also elsewhere on the board
/Analog Inputs/ADS_MISO: U4.22 (DOUT), U5.22 (DOUT); also elsewhere on the board
/Analog Inputs/ADS_MOSI: U4.23 (DIN), U5.23 (DIN); also elsewhere on the board
/Analog Inputs/ADS_SCLK: U4.24 (SCLK), U5.24 (SCLK); also elsewhere on the board
/Analog Inputs/IN1_N: U5.6 (AIN0); also elsewhere on the board
/Analog Inputs/IN2_N: U5.8 (AIN2); also elsewhere on the board
/Analog Inputs/IN2_P: U5.9 (AIN3); also elsewhere on the board
/Analog Inputs/IN3_N: U5.10 (AIN4); also elsewhere on the board
/Analog Inputs/IN3_P: U5.11 (AIN5); also elsewhere on the board
/Analog Inputs/IN4_N: U5.12 (AIN6); also elsewhere on the board
/Analog Inputs/IN4_P: U5.13 (AIN7); also elsewhere on the board
/Analog Inputs/IN5_N: U4.6 (AIN0); also elsewhere on the board
/Analog Inputs/IN5_P: U4.7 (AIN1); also elsewhere on the board
/Analog Inputs/IN6_N: U4.8 (AIN2); also elsewhere on the board
/Analog Inputs/IN6_P: U4.9 (AIN3); also elsewhere on the board
/Analog Inputs/IN7_N: U4.10 (AIN4); also elsewhere on the board
/Analog Inputs/IN7_P: U4.11 (AIN5); also elsewhere on the board
/Analog Inputs/IN8_N: U4.12 (AIN6); also elsewhere on the board
/Analog Inputs/IN8_P: U4.13 (AIN7); also elsewhere on the board
/Analog Inputs/REF_2.5V: C12.1, C14.1, C16.1, U3.6 (VREF), U4.4 (VREFP), U5.4 (VREFP)
/Analog Inputs/SENS1_A: J10.2; also elsewhere on the board
/Analog Inputs/SENS1_B: J10.1; also elsewhere on the board
/Analog Inputs/SENS2_A: J10.4; also elsewhere on the board
/Analog Inputs/SENS2_B: J10.3; also elsewhere on the board
/Analog Inputs/SENS3_A: J10.6; also elsewhere on the board
/Analog Inputs/SENS3_B: J10.5; also elsewhere on the board
/Analog Inputs/SENS4_A: J9.2; also elsewhere on the board
/Analog Inputs/SENS4_B: J9.1; also elsewhere on the board
/Analog Inputs/SENS5_A: J9.4; also elsewhere on the board
/Analog Inputs/SENS5_B: J9.3; also elsewhere on the board
/Analog Inputs/SENS6_A: J9.6; also elsewhere on the board
/Analog Inputs/SENS6_B: J9.5; also elsewhere on the board
/Analog Inputs/SENS7_A: J8.2; also elsewhere on the board
/Analog Inputs/SENS7_B: J8.1; also elsewhere on the board
/Analog Inputs/SENS8_A: J8.4; also elsewhere on the board
/Analog Inputs/SENS8_B: J8.3; also elsewhere on the board
GND: C1.2, C2.1, C3.2, C4.1, C5.2, C6.2, C7.2, C8.2, C9.2, C10.2, C11.2, C12.2, C13.2, C14.2, C15.2, C16.2, C17.2, C18.2, J8.5, U3.1 (GND), U3.2 (GND), U4.2 (AGND), U4.3 (VREFN), U4.17 (DGND), U5.2 (AGND), U5.3 (VREFN), U5.17 (DGND); also elsewhere on the board
unnamed: C11.1, U3.5 (NR)
unnamed: C1.1, U4.19 (XTAL1/CLKIN), Y1.2
unnamed: C2.2, U4.18 (XTAL2), Y1.1
unnamed: R1.2, U4.14 (~SYNC/~PDWN), U4.15 (~RESET)
unnamed: C3.1, U5.19 (XTAL1/CLKIN), Y2.2
unnamed: C4.2, U5.18 (XTAL2), Y2.1
unnamed: R2.2, U5.14 (~SYNC/~PDWN), U5.15 (~RESET)

Notes on the sheet:
C13585
C115962
C1658
C28186
Notes: ******** ADC ********** ~{CS} in LOW to enable SPI and DOUT. ~{DRDY} goes LOW after new data is available. ~{RESET} three forms: Input Pin, Reset command, SCLK patter. ~{SYNC} to control conversion. AINCOM isn't used in differential mode. Buffer On enable high impedance but decrese input vol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

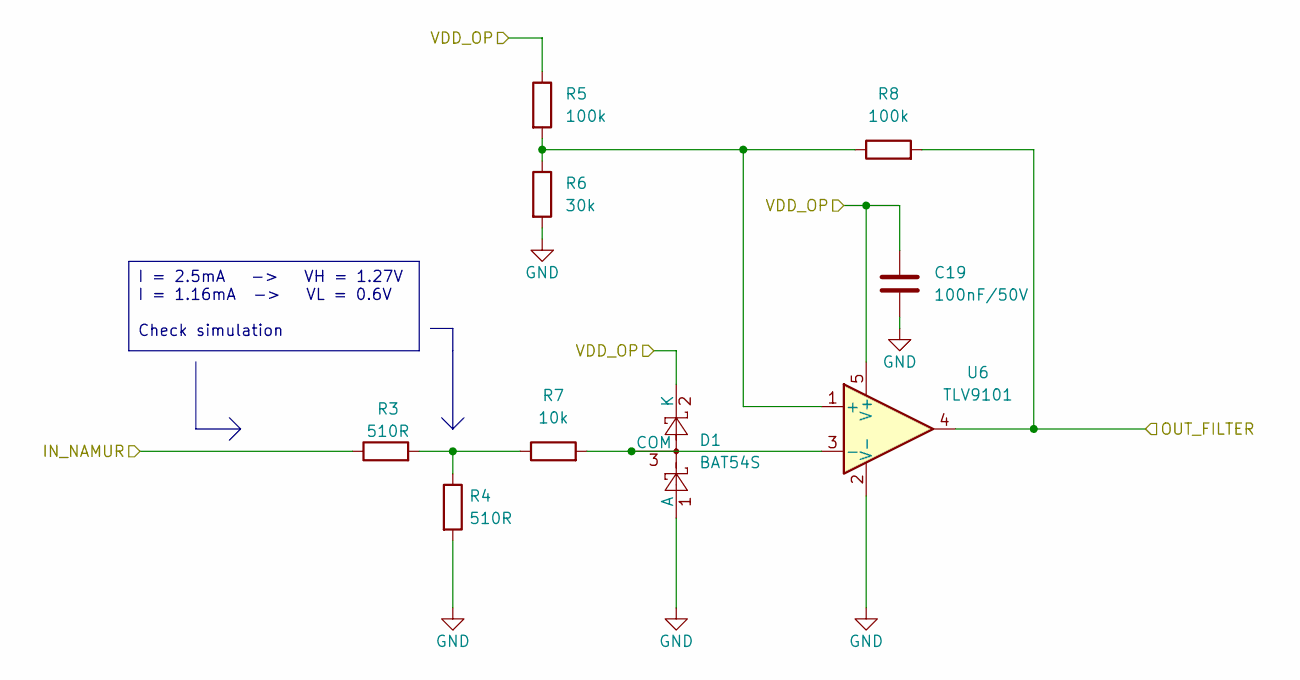
[picture p16: schematic Comparator_Hysteresis.kicad_sch]

Parts:
C19: 100nF/50V; C_0603_1608Metric
D1: BAT54S; SOT-23
R3, R4: 510R; R_0603_1608Metric
R5, R8: 100k; R_0603_1608Metric
R6: 30k; R_0603_1608Metric
R7: 10k; R_0603_1608Metric
U6: TLV9101; SC70-5_TexasInstruments

Connections:
/Digital Inputs/DIG_2: R8.2, U6.4; also elsewhere on the board
/Digital Inputs/NAMUR_2: R3.1; also elsewhere on the board
GND: C19.2, D1.1 (A), R4.2, R6.2, U6.2 (V-); also elsewhere on the board
unnamed: D1.3 (COM), R7.2, U6.3 (-)
unnamed: R3.2, R4.1, R7.1
unnamed: R5.2, R6.1, R8.1, U6.1 (+)

Parts of its further copies:
C66, C67, C68, C69, C70, C71, C72, C73: 100nF/50V; C_0603_1608Metric
D3, D5, D7, D9, D11, D13, D15, D17: BAT54S; SOT-23
R60, R61, R67, R68, R74, R75, R81, R82, R88, R89, R95, R96, R102, R103, R109, R110: 510R; R_0603_1608Metric
R62, R65, R69, R72, R76, R79, R83, R86, R90, R93, R97, R100, R104, R107, R111, R114: 100k; R_0603_1608Metric
R63, R70, R77, R84, R91, R98, R105, R112: 30k; R_0603_1608Metric
R64, R71, R78, R85, R92, R99, R106, R113: 10k; R_0603_1608Metric
U14, U15, U16, U17, U18, U19, U20, U21: TLV9101; SC70-5_TexasInstruments

Connections of its further copies:
/Digital Inputs/DIG_1: R65.2, U14.4; also elsewhere on the board
/Digital Inputs/DIG_3: R72.2, U15.4; also elsewhere on the board
/Digital Inputs/DIG_4: R79.2, U16.4; also elsewhere on the board
/Digital Inputs/DIG_5: R86.2, U17.4; also elsewhere on the board
/Digital Inputs/DIG_6: R93.2, U18.4; also elsewhere on the board
/Digital Inputs/DIG_7: R100.2, U19.4; also elsewhere on the board
/Digital Inputs/DIG_8: R107.2, U20.4; also elsewhere on the board
/Digital Inputs/DIG_9: R114.2, U21.4; also elsewhere on the board
/Digital Inputs/NAMUR_1: R60.1; also elsewhere on the board
/Digital Inputs/NAMUR_3: R67.1; also elsewhere on the board
/Digital Inputs/NAMUR_4: R74.1; also elsewhere on the board
/Digital Inputs/NAMUR_5: R81.1; also elsewhere on the board
/Digital Inputs/NAMUR_6: R88.1; also elsewhere on the board
/Digital Inputs/NAMUR_7: R95.1; also elsewhere on the board
/Digital Inputs/NAMUR_8: R102.1; also elsewhere on the board
/Digital Inputs/NAMUR_9: R109.1; also elsewhere on the board
GND: C66.2, C67.2, C68.2, C69.2, C70.2, C71.2, C72.2, C73.2, D3.1 (A), D5.1 (A), D7.1 (A), D9.1 (A), D11.1 (A), D13.1 (A), D15.1 (A), D17.1 (A), R61.2, R63.2, R68.2, R70.2, R75.2, R77.2, R82.2, R84.2, R89.2, R91.2, R96.2, R98.2, R103.2, R105.2, R110.2, R112.2, U14.2 (V-), U15.2 (V-), U16.2 (V-), U17.2 (V-), U18.2 (V-), U19.2 (V-), U20.2 (V-), U21.2 (V-); also elsewhere on the board
unnamed: D3.3 (COM), R64.2, U14.3 (-)
unnamed: D5.3 (COM), R71.2, U15.3 (-)
unnamed: D7.3 (COM), R78.2, U16.3 (-)
unnamed: D9.3 (COM), R85.2, U17.3 (-)
unnamed: D11.3 (COM), R92.2, U18.3 (-)
unnamed: D13.3 (COM), R99.2, U19.3 (-)
unnamed: D15.3 (COM), R106.2, U20.3 (-)
unnamed: D17.3 (COM), R113.2, U21.3 (-)
unnamed: R60.2, R61.1, R64.1
unnamed: R67.2, R68.1, R71.1
unnamed: R74.2, R75.1, R78.1
unnamed: R81.2, R82.1, R85.1
unnamed: R88.2, R89.1, R92.1
unnamed: R95.2, R96.1, R99.1
unnamed: R102.2, R103.1, R106.1
unnamed: R109.2, R110.1, R113.1
unnamed: R62.2, R63.1, R65.1, U14.1 (+)
unnamed: R69.2, R70.1, R72.1, U15.1 (+)
unnamed: R76.2, R77.1, R79.1, U16.1 (+)
unnamed: R83.2, R84.1, R86.1, U17.1 (+)
unnamed: R90.2, R91.1, R93.1, U18.1 (+)
unnamed: R97.2, R98.1, R100.1, U19.1 (+)
unnamed: R104.2, R105.1, R107.1, U20.1 (+)
unnamed: R111.2, R112.1, R114.1, U21.1 (+)

Notes on the sheet:
I = 2.5mA -> VH = 1.27V I = 1.16mA -> VL = 0.6V Check simulation

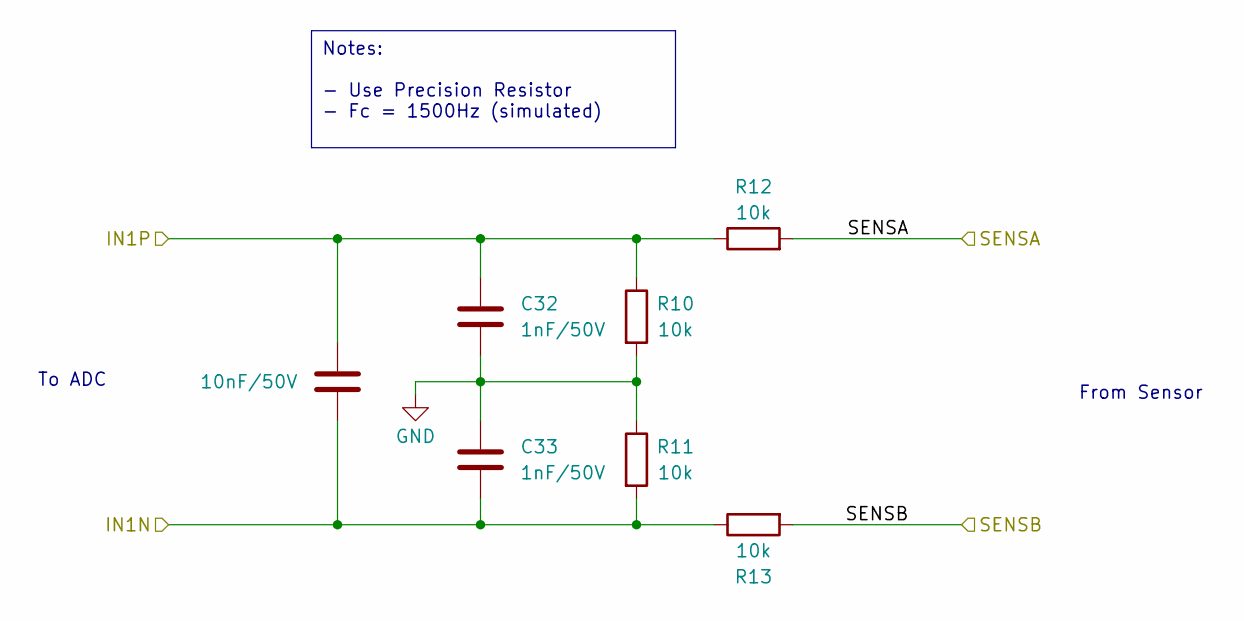
[picture p17: schematic LoadCell_Filter.kicad_sch]

Parts:
C31: 10nF/50V; C_0603_1608Metric
C32, C33: 1nF/50V; C_0603_1608Metric
R10, R11, R12, R13: 10k; R_0603_1608Metric

Connections:
/Analog Inputs/IN4_N: C31.2, C33.2, R11.2, R13.1; also elsewhere on the board
/Analog Inputs/IN4_P: C31.1, C32.1, R10.1, R12.1; also elsewhere on the board
/Analog Inputs/SENS4_A: R12.2; also elsewhere on the board
/Analog Inputs/SENS4_B: R13.2; also elsewhere on the board
GND: C32.2, C33.1, R10.2, R11.1; also elsewhere on the board

Parts of its further copies:
C34, C37, C40, C43, C46, C49, C63: 10nF/50V; C_0603_1608Metric
C35, C36, C38, C39, C41, C42, C44, C45, C47, C48, C50, C51, C64, C65: 1nF/50V; C_0603_1608Metric
R14, R15, R16, R17, R18, R19, R20, R21, R22, R23, R24, R25, R26, R27, R28, R29, R30, R31, R32, R33, R34, R35, R36, R37, R56, R57, R58, R59: 10k; R_0603_1608Metric

Connections of its further copies:
/Analog Inputs/IN1_N: C40.2, C42.2, R23.2, R25.1; also elsewhere on the board
/Analog Inputs/IN2_N: C34.2, C36.2, R15.2, R17.1; also elsewhere on the board
/Analog Inputs/IN2_P: C34.1, C35.1, R14.1, R16.1; also elsewhere on the board
/Analog Inputs/IN3_N: C37.2, C39.2, R19.2, R21.1; also elsewhere on the board
/Analog Inputs/IN3_P: C37.1, C38.1, R18.1, R20.1; also elsewhere on the board
/Analog Inputs/IN5_N: C63.2, C65.2, R57.2, R59.1; also elsewhere on the board
/Analog Inputs/IN5_P: C63.1, C64.1, R56.1, R58.1; also elsewhere on the board
/Analog Inputs/IN6_N: C49.2, C51.2, R35.2, R37.1; also elsewhere on the board
/Analog Inputs/IN6_P: C49.1, C50.1, R34.1, R36.1; also elsewhere on the board
/Analog Inputs/IN7_N: C46.2, C48.2, R31.2, R33.1; also elsewhere on the board
/Analog Inputs/IN7_P: C46.1, C47.1, R30.1, R32.1; also elsewhere on the board
/Analog Inputs/IN8_N: C43.2, C45.2, R27.2, R29.1; also elsewhere on the board
/Analog Inputs/IN8_P: C43.1, C44.1, R26.1, R28.1; also elsewhere on the board
/Analog Inputs/SENS1_A: R24.2; also elsewhere on the board
/Analog Inputs/SENS1_B: R25.2; also elsewhere on the board
/Analog Inputs/SENS2_A: R16.2; also elsewhere on the board
/Analog Inputs/SENS2_B: R17.2; also elsewhere on the board
/Analog Inputs/SENS3_A: R20.2; also elsewhere on the board
/Analog Inputs/SENS3_B: R21.2; also elsewhere on the board
/Analog Inputs/SENS5_A: R58.2; also elsewhere on the board
/Analog Inputs/SENS5_B: R59.2; also elsewhere on the board
/Analog Inputs/SENS6_A: R36.2; also elsewhere on the board
/Analog Inputs/SENS6_B: R37.2; also elsewhere on the board
/Analog Inputs/SENS7_A: R32.2; also elsewhere on the board
/Analog Inputs/SENS7_B: R33.2; also elsewhere on the board
/Analog Inputs/SENS8_A: R28.2; also elsewhere on the board
/Analog Inputs/SENS8_B: R29.2; also elsewhere on the board
GND: C35.2, C36.1, C38.2, C39.1, C41.2, C42.1, C44.2, C45.1, C47.2, C48.1, C50.2, C51.1, C64.2, C65.1, R14.2, R15.1, R18.2, R19.1, R22.2, R23.1, R26.2, R27.1, R30.2, R31.1, R34.2, R35.1, R56.2, R57.1; also elsewhere on the board

Notes on the sheet:
To ADC
From Sensor
Notes: - Use Precision Resistor - Fc = 1500Hz (simulated)

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
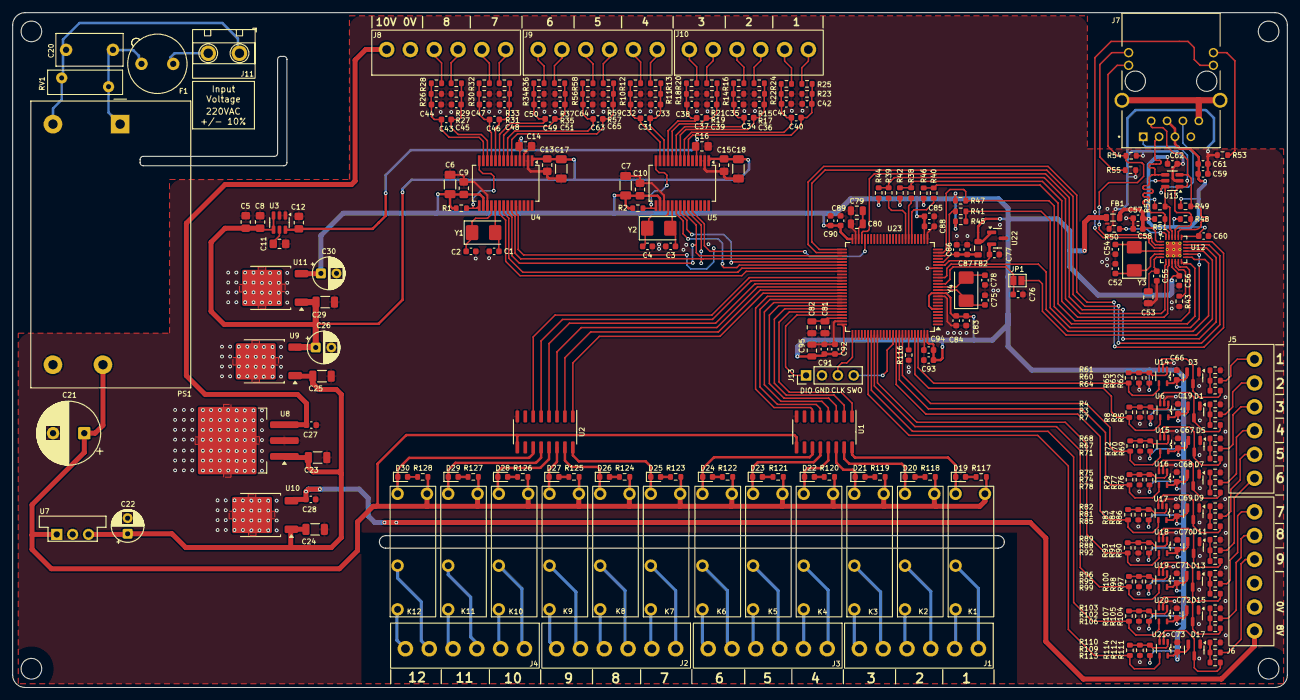
[picture p18: board Placa_Control_M2ES.kicad_pcb from above]

Board: 2 copper layers, 204.0 x 108.0 mm, 291 parts (0 on the bottom side), 202 nets.
