FarwayDot/251115_ControlBoard/(commit log)

2025-11-15 Primer Commit
    [Analog Inputs.kicad_sch, Digital Inputs.kicad_sch, Digital Outputs.kicad_sch, Ethernet.kicad_sch, Fuente.kicad_sch, Placa_Control_M2ES.kicad_pcb, Placa_Control_M2ES.kicad_sch, c-5-1393239-5-f-3d.stp]
2025-11-17 Avance con el ADC para conectar al filtro para las celdas. Se debe realizar un excel para el cálculo del peso y cuadrar bien esa sección para que la programación sea lo más sencilla posible
    [Analog Inputs.kicad_sch, Digital Outputs.kicad_sch, LoadCell_Filter.kicad_sch]
2025-11-18 Se culmina en que se utilizarà un filtro a 1.5khz para el sensor con divisor de 10k para la entrada ananaloga para el adc externo
    [Analog Inputs.kicad_sch, Histeresis_namur.xlsx, LoadCell_Filter.kicad_sch, LoadCells.xlsx]
2025-11-19 Se termina el circuito de entrada análoga, se escoge la bornera. Se termina las salidas de rele, se asumen que se trabajara maximo a 220V y solo para activar contactores. El circuito para el sensor n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
    [15EDGK-3.81-06P-14-00A&Z(H).stp, 15EDGRC-3.81-06P-1Y-00A&Z(H).stp, Analog Inputs.kicad_sch, Comparator_Hysteresis.kicad_sch, Digital Inputs.kicad_sch, Digital Outputs.kicad_sch, Ethernet.kicad_sch, HF46F[1].stp]
2025-11-21 avance de pcb, se considera borneras externas para conexión de alimentación
    [15EDGK-3.81-04P-14-00A&Z(H).stp, 15EDGVC-3.81-04P-14-00A&Z(H).stp, Analog Inputs.kicad_sch, Comparator_Hysteresis.kicad_sch, Digital Inputs.kicad_sch, Digital Outputs.kicad_sch, Ethernet.kicad_sch, Fuente.kicad_sch]
2025-11-22 Avance del posicionamiento
    [Digital Inputs.kicad_sch, Placa_Control_M2ES.kicad_pcb]
2025-11-24 Se empieza a evaluar la conexión del ethernet con la carcasa, parte analog, dig y micro en posición, tambien se busca solución para la salida de led de las entradas digitales
    [15EDGK-3.81-06P-14-00A&Z(H).stp, 15EDGK-3.81-06P-14-00AH.STEP, 15EDGVC-3.81-06P-14-00AH.STEP, Analog Inputs.kicad_sch, Digital Inputs.kicad_sch, Ethernet.kicad_sch, Placa_Control_M2ES.kicad_pcb, stm32.kicad_sch]
2025-11-25 Se traza vcc, digital, analog, relay, esta por terminar corregir GND y revisar nuevamente
    [Comparator_Hysteresis.kicad_sch, Ethernet.kicad_sch, Fuente.kicad_sch, Placa_Control_M2ES.kicad_pcb, stm32.kicad_sch]
2025-11-26 Se termina de revisar la placa. Se corrige la terminación de los transformadores internos del puerto ethernet. Se revisa GND, espaciado, añadimos notas. Falta enlazar las partes de JLCPCN
    [Analog Inputs.kicad_sch, BOM-Placa_Control_M2ES.csv, Ethernet.kicad_sch, IRM-10 v3.step, Placa_Control_M2ES.kicad_pcb, stm32.kicad_sch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]
2025-11-26 Se revisa informacion del ruteo para ethernet, los trazos MII y MDI pueden estar con un plano de GND adyacente. Lo que no puede tener acoplamiento es la parte magnética.
    [Placa_Control_M2ES.kicad_pcb]
